johnkok/iot_geiger/README.md

# IoT Geiger counter
IoT Geiger counter based on NINA-W106 u-blox module.  

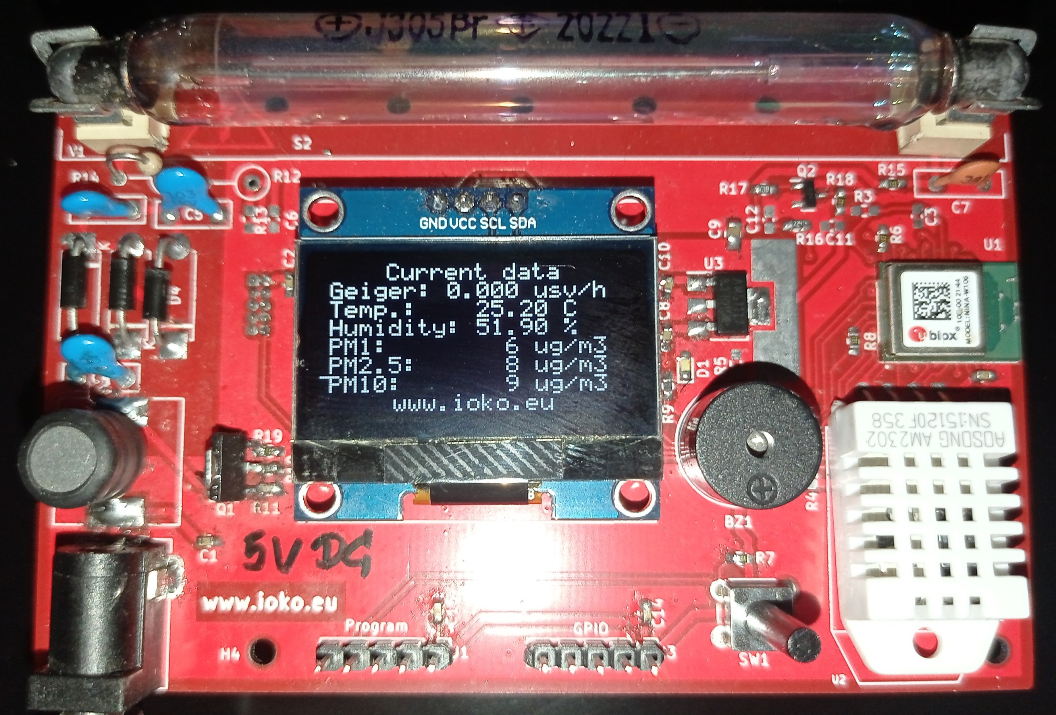
[picture p1: Doc/top.jpg]
IoT Geiger counter
