johnkok/iot_geiger/3D/geiger-front.stl

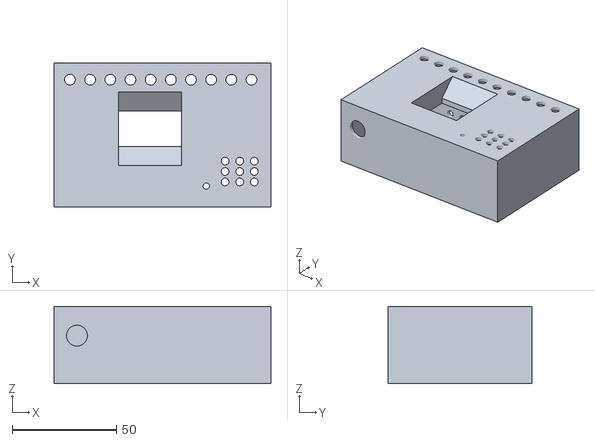
[picture p3: CAD file, 2022-12-11]
3D/geiger-front.stl
104.0 x 69.0 x 37.0
