johnkok/iot_geiger/3D/geiger-back.stl

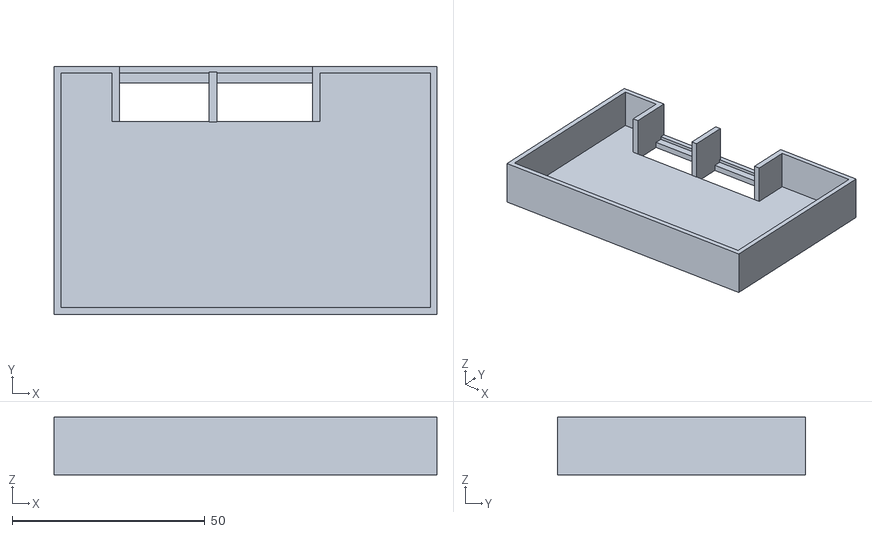
[picture p4: CAD file, 2022-12-11]
3D/geiger-back.stl
99.3 x 64.3 x 15.0
