johnkok/iot_geiger/PCB/iot_geiger/iot_geiger.kicad_pcb

## KiCad design PCB/iot_geiger/iot_geiger.kicad_pcb (2022-05-24)

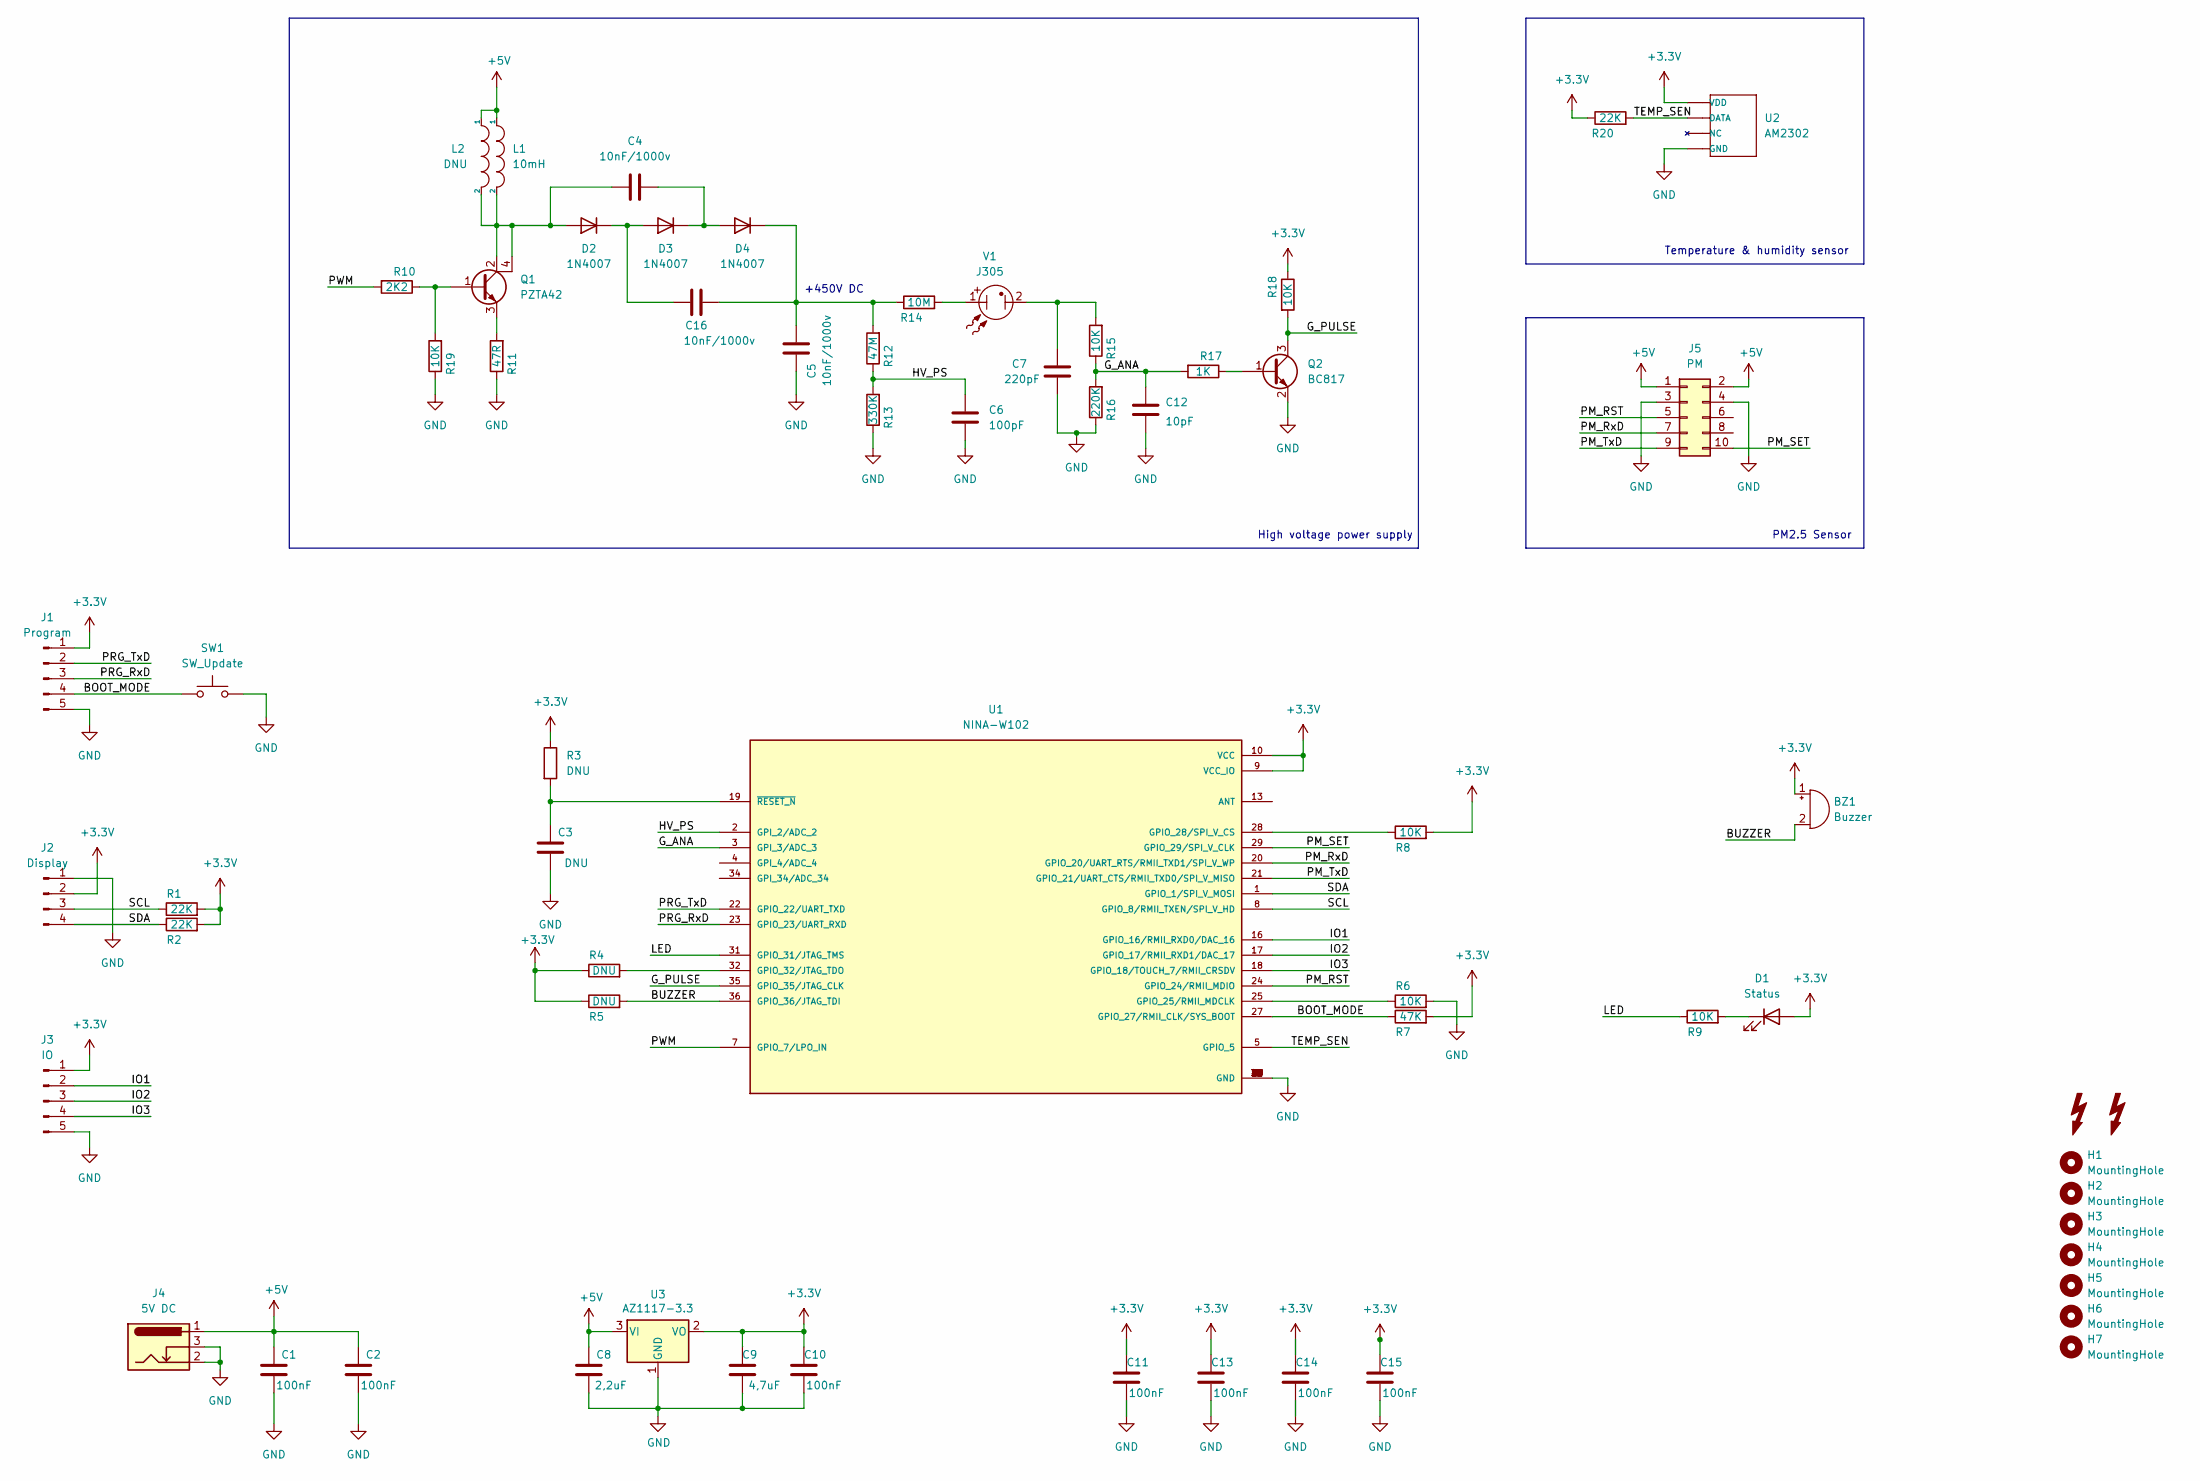
[picture p5: schematic iot_geiger.kicad_sch]

Parts:
BZ1: Buzzer; Buzzer_12x9.5RM7.6
C1, C2, C10, C11, C13, C14, C15: 100nF; C_0603_1608Metric
C3: DNU; C_0603_1608Metric
C4, C5, C16: 10nF/1000v; C_Disc_D7.5mm_W2.5mm_P5.00mm
C6: 100pF; C_0603_1608Metric_Pad1.08x0.95mm_HandSolder
C7: 220pF; C_Disc_D9.0mm_W2.5mm_P5.00mm
C8: 2,2uF; C_0603_1608Metric_Pad1.08x0.95mm_HandSolder
C9: 4,7uF; C_0805_2012Metric_Pad1.18x1.45mm_HandSolder
C12: 10pF; C_0603_1608Metric_Pad1.08x0.95mm_HandSolder
D1: Status; LED_0603_1608Metric_Pad1.05x0.95mm_HandSolder
D2, D3, D4: 1N4007; D_DO-41_SOD81_P10.16mm_Horizontal
H1, H2, H3, H4, H5, H6, H7: MountingHole; MountingHole_2.5mm
J1: Program; PinHeader_1x05_P2.54mm_Vertical
J2: Display; PinHeader_1x04_P2.54mm_Vertical
J3: IO; PinHeader_1x05_P2.54mm_Vertical
J4: 5V DC; BarrelJack_GCT_DCJ200-10-A_Horizontal
J5: PM; PinSocket_2x05_P1.27mm_Vertical
L1: 10mH; L_12x12mm_H6mm
L2: DNU; L_Radial_D10.0mm_P5.00mm_Fastron_07M
Q1: PZTA42; SOT-223
Q2: BC817; SOT-23
R1, R2, R20: 22K; R_0603_1608Metric_Pad0.98x0.95mm_HandSolder
R3, R4, R5: DNU; R_0603_1608Metric_Pad0.98x0.95mm_HandSolder
R6, R8, R9, R15, R18, R19: 10K; R_0603_1608Metric_Pad0.98x0.95mm_HandSolder
R7: 47K; R_0603_1608Metric_Pad0.98x0.95mm_HandSolder
R10: 2K2; R_0603_1608Metric_Pad0.98x0.95mm_HandSolder
R11: 47R; R_0603_1608Metric_Pad0.98x0.95mm_HandSolder
R12: 47M; R_Axial_DIN0309_L9.0mm_D3.2mm_P5.08mm_Vertical
R13: 330K; R_0603_1608Metric_Pad0.98x0.95mm_HandSolder
R14: 10M; R_Axial_DIN0309_L9.0mm_D3.2mm_P5.08mm_Vertical
R16: 220K; R_0603_1608Metric_Pad0.98x0.95mm_HandSolder
R17: 1K; R_0603_1608Metric_Pad0.98x0.95mm_HandSolder
S1, S2: SYM_Flash_Small; Symbol_HighVoltage_Type2_CopperTop_VerySmall
SW1: SW_Update; SW_PUSH_6mm_H4.3mm
U1: NINA-W102; XCVR_NINA-W102; PARTREV R05
U2: AM2302; SNR4-2.54-25.0X15.0X7.0MM; MPN AM2302
U3: AZ1117-3.3; SOT-223-3_TabPin2
V1: J305; Geiger

Connections:
+3V3: BZ1.1 (-), C9.2, C10.2, C11.2, C13.2, C14.2, C15.2, D1.2 (A), J1.1, J2.2, J3.1, R1.2, R2.2, R3.1, R4.1, R5.1, R7.2, R8.2, R18.1, R20.1, U1.9 (VCC_IO), U1.10 (VCC), U2.P$1 (VDD), U3.2 (VO)
+5V: C1.2, C2.2, C8.2, J4.1, J5.1, J5.2, L1.1, L2.1, U3.3 (VI)
/BOOT_MODE: J1.4, R7.1, SW1.1, U1.27 (GPIO_27/RMII_CLK/SYS_BOOT)
/BUZZER: BZ1.2 (+), R5.2, U1.36 (GPIO_36/JTAG_TDI)
/G_ANA: C12.2, R15.1, R16.2, R17.2, U1.3 (GPI_3/ADC_3)
/G_PULSE: Q2.3 (C), R18.2, U1.35 (GPIO_35/JTAG_CLK)
/HV_PS: C6.2, R12.1, R13.2, U1.2 (GPI_2/ADC_2)
/IO1: J3.2, U1.16 (GPIO_16/RMII_RXD0/DAC_16)
/IO2: J3.3, U1.17 (GPIO_17/RMII_RXD1/DAC_17)
/IO3: J3.4, U1.18 (GPIO_18/TOUCH_7/RMII_CRSDV)
/LED: R9.1, U1.31 (GPIO_31/JTAG_TMS)
/PM_RST: J5.5, U1.24 (GPIO_24/RMII_MDIO)
/PM_RxD: J5.7, U1.20 (GPIO_20/UART_RTS/RMII_TXD1/SPI_V_WP)
/PM_SET: J5.10, U1.29 (GPIO_29/SPI_V_CLK)
/PM_TxD: J5.9, U1.21 (GPIO_21/UART_CTS/RMII_TXD0/SPI_V_MISO)
/PRG_RxD: J1.3, U1.23 (GPIO_23/UART_RXD)
/PRG_TxD: J1.2, U1.22 (GPIO_22/UART_TXD)
/PWM: R10.2, U1.7 (GPIO_7/LPO_IN)
/SCL: J2.3, R1.1, U1.8 (GPIO_8/RMII_TXEN/SPI_V_HD)
/SDA: J2.4, R2.1, U1.1 (GPIO_1/SPI_V_MOSI)
/TEMP_SEN: R20.2, U1.5 (GPIO_5), U2.P$2 (DATA)
GND: C1.1, C2.1, C3.1, C5.1, C6.1, C7.1, C8.1, C9.1, C10.1, C11.1, C12.1, C13.1, C14.1, C15.1, J1.5, J2.1, J3.5, J4.2, J4.3, J5.3, J5.4, Q2.2 (E), R6.2, R11.1, R13.1, R16.1, R19.1, SW1.2, U1.6 (GND), U1.12 (GND), U1.14 (GND), U1.26 (GND), U1.30 (GND), U1.37 (GND), U1.38 (GND), U1.39 (GND), U1.40 (GND), U1.41 (GND), U1.42 (GND), U1.43 (GND), U1.44 (GND), U1.45 (GND), U1.46 (GND), U1.47 (GND), U1.48 (GND), U2.P$4 (GND), U3.1 (GND)
unnamed: C3.2, R3.2, U1.19 (~RESET_N)
unnamed: C4.1, D2.2 (A), L1.2, L2.2, Q1.2 (C), Q1.4 (C)
unnamed: C4.2, D3.1 (K), D4.2 (A)
unnamed: C7.2, R15.2, V1.2
unnamed: C16.1, D2.1 (K), D3.2 (A)
unnamed: C5.2, C16.2, D4.1 (K), R12.2, R14.1
unnamed: D1.1 (K), R9.2
unnamed: Q1.1 (B), R10.1, R19.2
unnamed: Q1.3 (E), R11.2
unnamed: Q2.1 (B), R17.1
unnamed: R4.2, U1.32 (GPIO_32/JTAG_TDO)
unnamed: R6.1, U1.25 (GPIO_25/RMII_MDCLK)
unnamed: R8.1, U1.28 (GPIO_28/SPI_V_CS)
unnamed: R14.2, V1.1

Notes on the sheet:
PM2.5 Sensor
+450V DC
High voltage power supply
Temperature & humidity sensor

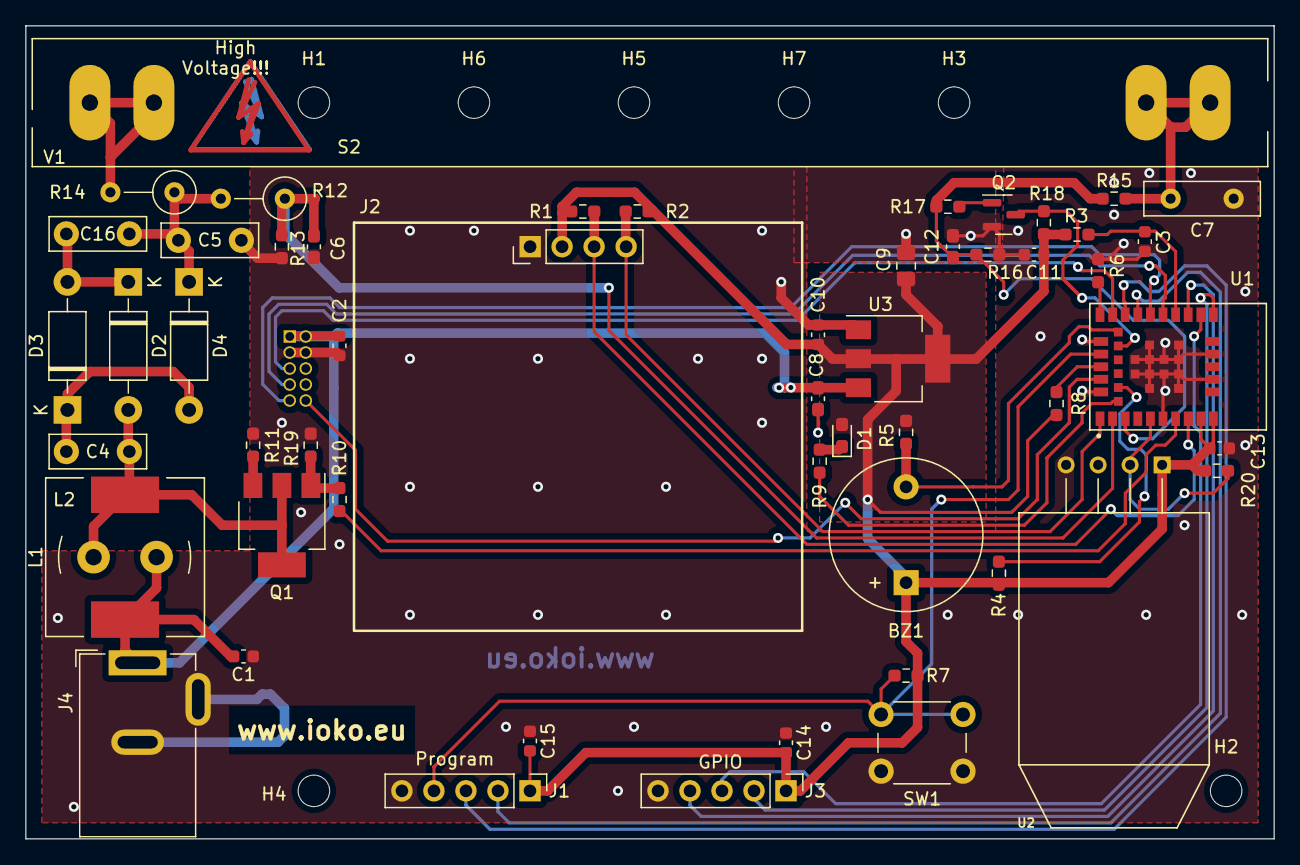
[picture p6: board iot_geiger.kicad_pcb from above]

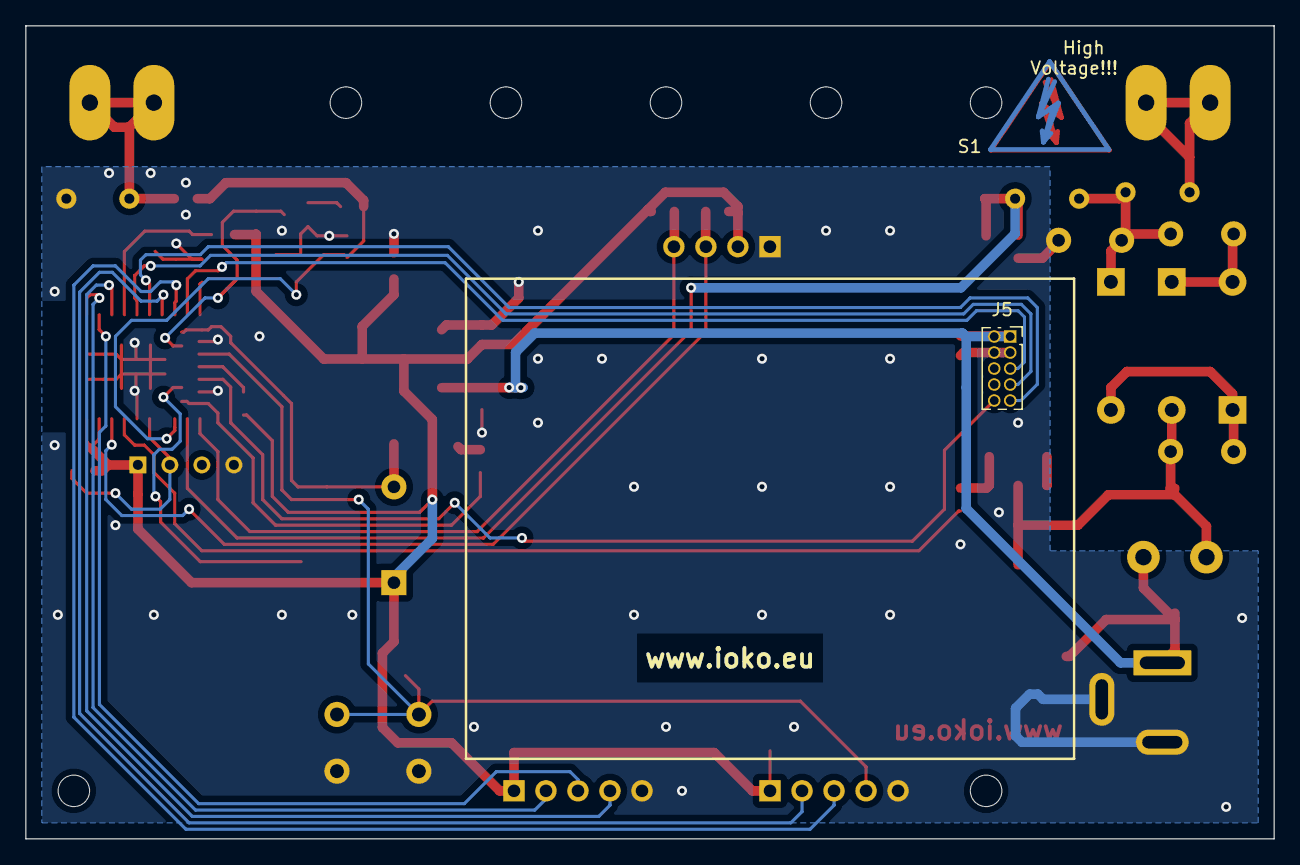
[picture p7: board iot_geiger.kicad_pcb from below]

Board: 2 copper layers, 99.1 x 64.5 mm, 64 parts (2 on the bottom side), 36 nets.
