johnkok/iot_geiger/FW/main/display.c

#include "display.h"
#include "fonts.h"
#include "mqtt_cli.h"
#include "geiger.h"

static const char *TAG = "DISPLAY";
extern rx_store_s rx_store;
extern esp_mqtt_client_handle_t client;
extern float gc_hourly[GC_LOG_CNT];
static unsigned char display = 0;

int i2c_master_port = 0;
i2c_config_t conf = {
    .mode = I2C_MODE_MASTER,
    .sda_io_num = 23, //I2C_MASTER_SDA_IO,         // select GPIO specific to your project
    .sda_pullup_en = GPIO_PULLUP_DISABLE,
    .scl_io_num = 21, //I2C_MASTER_SCL_IO,         // select GPIO specific to your project
    .scl_pullup_en = GPIO_PULLUP_DISABLE,
    .master.clk_speed = 100000, //I2C_MASTER_FREQ_HZ,  // select frequency specific to your project
//  .clk_flags = 0,          !< Optional, you can use I2C_SCLK_SRC_FLAG_* flags to choose i2c source clock here.
};
static uint8_t display_ram[8][130];

static esp_err_t __attribute__((unused)) i2c_master_write_slave(i2c_port_t i2c_num, uint8_t *data_wr, size_t size)
{
    i2c_cmd_handle_t cmd = i2c_cmd_link_create();
    i2c_master_start(cmd);
    i2c_master_write_byte(cmd, 0x78, 1);
    i2c_master_write(cmd, data_wr, size, 1);
    i2c_master_stop(cmd);
    esp_err_t ret = i2c_master_cmd_begin(i2c_num, cmd, 1000 / 10);
    i2c_cmd_link_delete(cmd);
    return ret;
}

void display_clear()
{
    memset(display_ram, 0x00, sizeof(display_ram));
}

void display_update(uint8_t *ram)
{
    unsigned char m,n;
    uint8_t buffer[2];

    for(m=0;m<8;m++)
    {
        buffer[0] = 0;
        buffer[1] = 0xB0 + m;
        i2c_master_write_slave(0, buffer, 2);
        buffer[1] = 0x00;
        i2c_master_write_slave(0, buffer, 2);
        buffer[1] = 0x10;
        i2c_master_write_slave(0, buffer, 2);

	for(n=0;n<130;n++)
        {
            buffer[0] = 0x40;
            buffer[1] = ram[m*130 + n];
            i2c_master_write_slave(0, buffer, 2);
        }
        buffer[1] = 0;
    }
}

int display_print(uint8_t *ram, uint8_t x, uint8_t y, char *text)
{
    for (int i = 0 ; i < strnlen(text, 21) ; i++)
    {
        for (int c = 0 ; c < 6 ; c++)
	{
            ram[y*130 + x+i*6 + c + 2] = fonts[(text[i] - 0x20)*6 + c];
	}
    }
    return 0;
}

static void *display_thread(void * arg)
{
    char buffer[64];
    int erase_delay;
    nvs_handle_t nvs_handle;
    unsigned char page = 0;

    ESP_LOGI(TAG, "Thread started!");
    while (true)
    {
        sleep(1);
        if (page & 0x08)
        {
            display_print(&display_ram[0][27], 0, 0, "Current data");
            sprintf(buffer, "Geiger: %2.3f usv/h", rx_store.current.gc_usv);
            display_print(&display_ram[1][4], 0, 0, buffer);
            sprintf(buffer, "Temp.:    %3.2f C", rx_store.current.temperature);
            display_print(&display_ram[2][4], 0, 0, buffer);
            sprintf(buffer, "Humidity: %3.2f %%", rx_store.current.humidity);
            display_print(&display_ram[3][4], 0, 0, buffer);
            sprintf(buffer, "PM1:   %6.0d ug/m3", rx_store.current.pm1);
            display_print(&display_ram[4][4], 0, 0, buffer);
            sprintf(buffer, "PM2.5: %6.0d ug/m3", rx_store.current.pm2_5);
            display_print(&display_ram[5][4], 0, 0, buffer);
            sprintf(buffer, "PM10:  %6.0d ug/m3", rx_store.current.pm10);
            display_print(&display_ram[6][4], 0, 0, buffer);        
            display_print(&display_ram[7][30], 0, 0, "www.ioko.eu");
            display_update(&display_ram[0][0]);
        }
        else
        {
            display_clear();
            for (int i = 0; i < GC_LOG_CNT ; i++)
            {   
                float meas = 0.0;
                if (gc_hourly[i] > 55.0) meas = 55;
		else meas = gc_hourly[i];
                for (int y = 1 ; y < 8 ; y++)
                {
                    if (meas > (y * 8.0)) display_ram[y-1][i] = 0xFF;
                    else if (meas > ((y * 8.0) - 1.0)) display_ram[y-1][i] = 0x7F;
		    else if (meas > ((y * 8.0) - 2.0)) display_ram[y-1][i] = 0x3F;
		    else if (meas > ((y * 8.0) - 3.0)) display_ram[y-1][i] = 0x1F;
		    else if (meas > ((y * 8.0) - 4.0)) display_ram[y-1][i] = 0x0F;
		    else if (meas > ((y * 8.0) - 5.0)) display_ram[y-1][i] = 0x07;
		    else if (meas > ((y * 8.0) - 6.0)) display_ram[y-1][i] = 0x03;
		    else if (meas > ((y * 8.0) - 7.0)) display_ram[y-1][i] = 0x01;
                    else display_ram[y-1][i] = 0;
		}

                display_ram[6][i] = display_ram[6][i] | 0x01;
            } 
            for (int i = 0; i < 7 ; i++)
            {
                display_ram[i][0] = 0xFF;
            }
	    display_print(&display_ram[7][42], 0, 0, "usv/h");

            display_update(&display_ram[0][0]);
        }
        // Check for factory reset
        erase_delay = 0;
        while (gpio_get_level(BUTTON_GPIO) == 0)
        {
            display_clear();
            display_print(&display_ram[0][27], 0, 0, "Erase data?");
            display_update(&display_ram[0][0]);
            erase_delay++;
            sleep(1);
            if (erase_delay == 5)
            {
                ESP_LOGI(TAG, "Erase NVS storage!");
	        nvs_open_from_partition("iot_geiger", "default", NVS_READWRITE, &nvs_handle);
                nvs_erase_all(nvs_handle);
                nvs_close(nvs_handle);
                display_clear();
                display_print(&display_ram[0][27], 0, 0, "Erase done!");
                display_update(&display_ram[0][0]);
                sleep(5);
                break;
            }
	}
        if (client != NULL)
        {
            mqtt_publish_data(client);
	}
	page++;
    }
    ESP_LOGE(TAG, "Thread ended!");

    return NULL;
}

void display_init(void)
{
    pthread_attr_t attr;
    pthread_t threadDisplay;

    uint8_t buffer[2];
    int ret;
    nvs_handle_t nvs_handle;

    memset(display_ram, 0, sizeof(display_ram));

    // Confidure BUZZER GPIO
    gpio_config_t io_conf = {};
    io_conf.intr_type = GPIO_INTR_DISABLE;
    io_conf.mode = GPIO_MODE_INPUT;
    io_conf.pin_bit_mask = 1U<<BUTTON_GPIO;
    io_conf.pull_down_en = 0;
    io_conf.pull_up_en = 0;
    gpio_config(&io_conf);

    i2c_driver_install(i2c_master_port, conf.mode, 0, 0, 0);
    i2c_param_config(i2c_master_port, &conf);
  
    vTaskDelay(10);

    uint8_t init_cmds[] = {0xAE, 0x20, 0x10, 0xB0, 0xC8, 0x00, 0x10, 0x40, 0x81, 0xDF, 0xA1, 0xA6, 0xA8, 0x3F, 0xA4, 0xD3, 0x00, 0xD5, 0xF0, 0xD9, 0x22, 0xDA, 0x12, 0xDB, 0x20, 0x8D, 0x20, 0x8D, 0x14, 0xAF};

    buffer[0] = 0;
    for (int i = 0; i < sizeof(init_cmds) ; i++)
    {
        buffer[1] = init_cmds[i];
        i2c_master_write_slave(0, buffer, 2);
    }

    if (nvs_open_from_partition("iot_geiger", "default", NVS_READONLY, &nvs_handle) == ESP_OK)
    {
        if (nvs_get_u8(nvs_handle, "display", &display) != ESP_OK)
        {
            ESP_LOGE(TAG, "display not in NVS");
        }
    }

    display_print(&display_ram[0][30], 0, 0, "www.ioko.eu");
    display_update(&display_ram[0][0]);

    // Start display thread
    ret = pthread_attr_init(&attr);
    assert(ret == 0);
    pthread_attr_setstacksize(&attr, 1024*5);
    ret = pthread_create(&threadDisplay, &attr, display_thread, NULL);
    assert(ret == 0);
}
