johnkok/iot_geiger/FW/main/wifi.c

#include "wifi.h"

/* FreeRTOS event group to signal when we are connected*/
static EventGroupHandle_t s_wifi_event_group;

static const char *TAG = "WIFI";

static int s_retry_num = 0;

char wifi_pass[32] = EXAMPLE_ESP_WIFI_PASS;
char wifi_ssid[32] = EXAMPLE_ESP_WIFI_SSID;

static void event_handler(void* arg, esp_event_base_t event_base,
                                int32_t event_id, void* event_data)
{
    if (event_base == WIFI_EVENT && event_id == WIFI_EVENT_STA_START) {
        esp_wifi_connect();
    } else if (event_base == WIFI_EVENT && event_id == WIFI_EVENT_STA_DISCONNECTED) {
        if (s_retry_num < EXAMPLE_ESP_MAXIMUM_RETRY) {
            esp_wifi_connect();
            s_retry_num++;
            ESP_LOGI(TAG, "retry to connect to the AP");
        } else {
            xEventGroupSetBits(s_wifi_event_group, WIFI_FAIL_BIT);
        }
        ESP_LOGI(TAG,"connect to the AP fail");
    } else if (event_base == IP_EVENT && event_id == IP_EVENT_STA_GOT_IP) {
        ip_event_got_ip_t* event = (ip_event_got_ip_t*) event_data;
        ESP_LOGI(TAG, "got ip:" IPSTR, IP2STR(&event->ip_info.ip));
        s_retry_num = 0;
        xEventGroupSetBits(s_wifi_event_group, WIFI_CONNECTED_BIT);
    } else if (event_id == WIFI_EVENT_AP_STACONNECTED) {
        wifi_event_ap_staconnected_t* event = (wifi_event_ap_staconnected_t*) event_data;
        ESP_LOGI(TAG, "station "MACSTR" join, AID=%d", MAC2STR(event->mac), event->aid);
    } else if (event_id == WIFI_EVENT_AP_STADISCONNECTED) {
        wifi_event_ap_stadisconnected_t* event = (wifi_event_ap_stadisconnected_t*) event_data;
        ESP_LOGI(TAG, "station "MACSTR" leave, AID=%d", MAC2STR(event->mac), event->aid);
    }

}

void wifi_init_softap(void)
{
    esp_netif_create_default_wifi_ap();

    wifi_init_config_t cfg = WIFI_INIT_CONFIG_DEFAULT();
    ESP_ERROR_CHECK(esp_wifi_init(&cfg));

    ESP_ERROR_CHECK(esp_event_handler_instance_register(WIFI_EVENT,
                                                        ESP_EVENT_ANY_ID,
                                                        &event_handler,
                                                        NULL,
                                                        NULL));

    wifi_config_t wifi_config = {
        .ap = {
            .ssid = EXAMPLE_ESP_WIFI_SSID,
            .ssid_len = strlen(EXAMPLE_ESP_WIFI_SSID),
            .channel = EXAMPLE_ESP_WIFI_CHANNEL,
            .password = EXAMPLE_ESP_WIFI_PASS,
            .max_connection = EXAMPLE_MAX_STA_CONN,
            .authmode = WIFI_AUTH_WPA_WPA2_PSK,
        },
    };
    memset((char *)wifi_config.ap.ssid, 0x00, 32);
    memset((char *)wifi_config.ap.password, 0x00, 32);
    strncpy((char *)wifi_config.ap.ssid, wifi_ssid, strnlen(wifi_ssid,32));
    strncpy((char *)wifi_config.ap.password, wifi_pass, strnlen(wifi_pass,32));
    wifi_config.ap.ssid_len = strnlen(wifi_ssid,32);
    if (strlen(EXAMPLE_ESP_WIFI_PASS) == 0) {
        wifi_config.ap.authmode = WIFI_AUTH_OPEN;
    }
    ESP_ERROR_CHECK(esp_wifi_set_mode(WIFI_MODE_AP));
    ESP_ERROR_CHECK(esp_wifi_set_config(WIFI_IF_AP, &wifi_config));
    ESP_ERROR_CHECK(esp_wifi_start());

    ESP_LOGI(TAG, "wifi_init_softap finished. SSID:%s password:%s channel:%d",
             wifi_ssid, wifi_pass, EXAMPLE_ESP_WIFI_CHANNEL);
}

void wifi_init_sta(void)
{
   
    s_wifi_event_group = xEventGroupCreate();

    esp_netif_create_default_wifi_sta();

    wifi_init_config_t cfg = WIFI_INIT_CONFIG_DEFAULT();
    ESP_ERROR_CHECK(esp_wifi_init(&cfg));

    esp_event_handler_instance_t instance_any_id;
    esp_event_handler_instance_t instance_got_ip;
    ESP_ERROR_CHECK(esp_event_handler_instance_register(WIFI_EVENT,
                                                        ESP_EVENT_ANY_ID,
                                                        &event_handler,
                                                        NULL,
                                                        &instance_any_id));
    ESP_ERROR_CHECK(esp_event_handler_instance_register(IP_EVENT,
                                                        IP_EVENT_STA_GOT_IP,
                                                        &event_handler,
                                                        NULL,
                                                        &instance_got_ip));
    
    wifi_config_t wifi_config = {
        .sta = {
            .ssid = EXAMPLE_ESP_WIFI_SSID,
            .password = EXAMPLE_ESP_WIFI_PASS,
            /* Setting a password implies station will connect to all security modes including WEP/WPA.
             * However these modes are deprecated and not advisable to be used. Incase your Access point
             * doesn't support WPA2, these mode can be enabled by commenting below line */
	     .threshold.authmode = WIFI_AUTH_WPA2_PSK,

             .pmf_cfg = {
                 .capable = true,
                 .required = false
            },
        },
    };
    memset((char *)wifi_config.sta.ssid, 0x00, 32);
    memset((char *)wifi_config.sta.password, 0x00, 32);
    strncpy((char *)wifi_config.sta.ssid, wifi_ssid, strnlen(wifi_ssid,32));
    strncpy((char *)wifi_config.sta.password, wifi_pass, strnlen(wifi_pass,32));

    ESP_ERROR_CHECK(esp_wifi_set_mode(WIFI_MODE_STA) );
    ESP_ERROR_CHECK(esp_wifi_set_config(WIFI_IF_STA, &wifi_config) );
    ESP_ERROR_CHECK(esp_wifi_start() );

    ESP_LOGI(TAG, "wifi_init_sta finished.");

    /* Waiting until either the connection is established (WIFI_CONNECTED_BIT) or connection failed for the maximum
     * number of re-tries (WIFI_FAIL_BIT). The bits are set by event_handler() (see above) */
    EventBits_t bits = xEventGroupWaitBits(s_wifi_event_group,
            WIFI_CONNECTED_BIT | WIFI_FAIL_BIT,
            pdFALSE,
            pdFALSE,
            portMAX_DELAY);

    /* xEventGroupWaitBits() returns the bits before the call returned, hence we can test which event actually
     * happened. */
    if (bits & WIFI_CONNECTED_BIT) {
        ESP_LOGI(TAG, "connected to ap SSID:%s password:%s.",
                 wifi_ssid, wifi_pass);
    } else if (bits & WIFI_FAIL_BIT) {
        ESP_LOGI(TAG, "Failed to connect to SSID:%s, password:%s.",
                 wifi_ssid, wifi_pass);
    } else {
        ESP_LOGE(TAG, "UNEXPECTED EVENT");
    }

    /* The event will not be processed after unregister */
    ESP_ERROR_CHECK(esp_event_handler_instance_unregister(IP_EVENT, IP_EVENT_STA_GOT_IP, instance_got_ip));
    ESP_ERROR_CHECK(esp_event_handler_instance_unregister(WIFI_EVENT, ESP_EVENT_ANY_ID, instance_any_id));
    vEventGroupDelete(s_wifi_event_group);
}

void wifi_init(void)
{
uint8_t wifi_mode = 0;
esp_err_t ret;
nvs_handle_t nvs_handle;
size_t required_size;

    ret = nvs_open_from_partition("iot_geiger", "default",
                                      NVS_READONLY, &nvs_handle);

    ret = nvs_get_u8(nvs_handle, "wifi_mode", &wifi_mode);
    if (ret != ESP_OK)
    {
        ESP_LOGE(TAG, "WIFI Mode not in NVS");
    }

    required_size = 32;
    ret = nvs_get_str(nvs_handle, "wifi_ssid", &wifi_ssid[0], &required_size);
    if (ret != ESP_OK)
    {
        ESP_LOGE(TAG, "WIFI ssid not in NVS");
    }

    required_size = 32;
    ret = nvs_get_str(nvs_handle, "wifi_pass", &wifi_pass[0], &required_size);
    if (ret != ESP_OK)
    {
        ESP_LOGE(TAG, "WIFI pass not in NVS");
    }

    nvs_close(nvs_handle);
    
    if (wifi_mode == 0)
    {
        ESP_LOGI(TAG, "ESP_WIFI_MODE_AP");
        wifi_init_softap();
    }
    else
    {
        ESP_LOGI(TAG, "ESP_WIFI_MODE_STA");
        wifi_init_sta();
    }
}
