johnkok/iot_geiger/FW/main/web_server.h

#ifndef __WEB_SERVER_H__
#define __WEB_SERVER_H__

#include "main.h"

#define CONFIG_EXAMPLE_BASIC_AUTH_USERNAME "iot"
#define CONFIG_EXAMPLE_BASIC_AUTH_PASSWORD "iot"

#define SCRATCH_BUFSIZE (1024*10)

void web_init(void);

#endif
