johnkok/iot_geiger/FW/main/pwm.c

#include "pwm.h"

static const char *TAG = "PWM";

static void *pwm_thread(void * arg)
{
    ESP_LOGI(TAG, "Thread started!");

    // Prepare and then apply the LEDC PWM channel configuration
    ledc_channel_config_t ledc_channel = {
        .speed_mode     = LEDC_MODE,
        .channel        = LEDC_CHANNEL,
        .timer_sel      = LEDC_TIMER,
        .intr_type      = LEDC_INTR_DISABLE,
        .gpio_num       = LEDC_OUTPUT_IO,
        .duty           = LEDC_DUTY, // Set duty to 0%
        .hpoint         = 0
    };
    ESP_ERROR_CHECK(ledc_channel_config(&ledc_channel));

    // Prepare and then apply the LEDC PWM timer configuration
    ledc_timer_config_t ledc_timer = {
        .speed_mode       = LEDC_MODE,
        .timer_num        = LEDC_TIMER,
        .duty_resolution  = LEDC_DUTY_RES,
        .freq_hz          = LEDC_FREQUENCY,  // Set output frequency at 5 kHz
        .clk_cfg          = LEDC_USE_APB_CLK
    };
    ESP_ERROR_CHECK(ledc_timer_config(&ledc_timer));

    ESP_ERROR_CHECK(ledc_set_duty(LEDC_MODE, LEDC_CHANNEL, LEDC_DUTY));
    ESP_ERROR_CHECK(ledc_update_duty(LEDC_MODE, LEDC_CHANNEL));

    while (true)
    {
        sleep(1);
    }
    ESP_LOGE(TAG, "Thread ended!");

    return NULL;
}

void pwm_init(void)
{
    pthread_attr_t attr;
    pthread_t threadPwm;
    int ret;

    // Start PWM thread
    ret = pthread_attr_init(&attr);
    assert(ret == 0);
    pthread_attr_setstacksize(&attr, 1024*2);
    ret = pthread_create(&threadPwm, &attr, pwm_thread, NULL);
    assert(ret == 0);
}
