johnkok/iot_geiger/(commit log)

2022-04-20 Initial PCB added
    [iot_geiger.kicad_pcb, iot_geiger.kicad_sch]
2022-04-24 fix spiffs
    [iot_geiger.kicad_pcb, iot_geiger.kicad_sch, partitions.csv]
2022-05-05 Add PM sensor support
    [iot_geiger-B_Cu.gbr, iot_geiger-B_Mask.gbr, iot_geiger-B_Paste.gbr, iot_geiger-B_Silkscreen.gbr, iot_geiger-Edge_Cuts.gbr, iot_geiger-F_Cu.gbr, iot_geiger-F_Mask.gbr, iot_geiger-F_Paste.gbr]
2022-05-20 PWM added
2022-05-20 PCB updated
2022-05-22 AP added
    [iot_geiger.kicad_pcb, iot_geiger.kicad_sch, partitions.csv]
2022-05-24 add webserver
    [iot_geiger-B_Cu.gbr, iot_geiger-B_Mask.gbr, iot_geiger-B_Paste.gbr, iot_geiger-B_Silkscreen.gbr, iot_geiger-Edge_Cuts.gbr, iot_geiger-F_Cu.gbr, iot_geiger-F_Mask.gbr, iot_geiger-F_Paste.gbr]
2022-12-11 Add 3D case files
    [geiger-back.stl, geiger-front.stl]
2022-12-11 add schematic image
